MohamedReda2003/Robot-PROJET2A/Fichiers PDF/Initiation Projet 2A.pdf

Les grandes parties :

- Repérer les mauvaises herbes
https://www.agrireseau.net/documents/Document_114518.pdfhttps://docs.ultralytics.com/fr/tasks/segmenthttps://www.researchgate.net/publication/396391525_A_ROS_2-Based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 gn
- Faire bouger le bras (optimiser...)
- Faire déplacer le robot (chenille mécanique armature)
- Être capable de schématiser et visualiser le trajet et détecter tous les obstacles potentiels (on peut utiliser un Lidar360 pour cette tache)
- À rechercher si on peut ajouter le concept de PBC (Passivity-Based Control model) pour assurer l’équilibre du bras robotique lors de son fonctionnement
- Préparer les matrices de transformation du bras robotique pour la contrôler (MGD à DH modifiée et MGI)

https://docs.niryo.com/robots/ned2/electrical-interface/

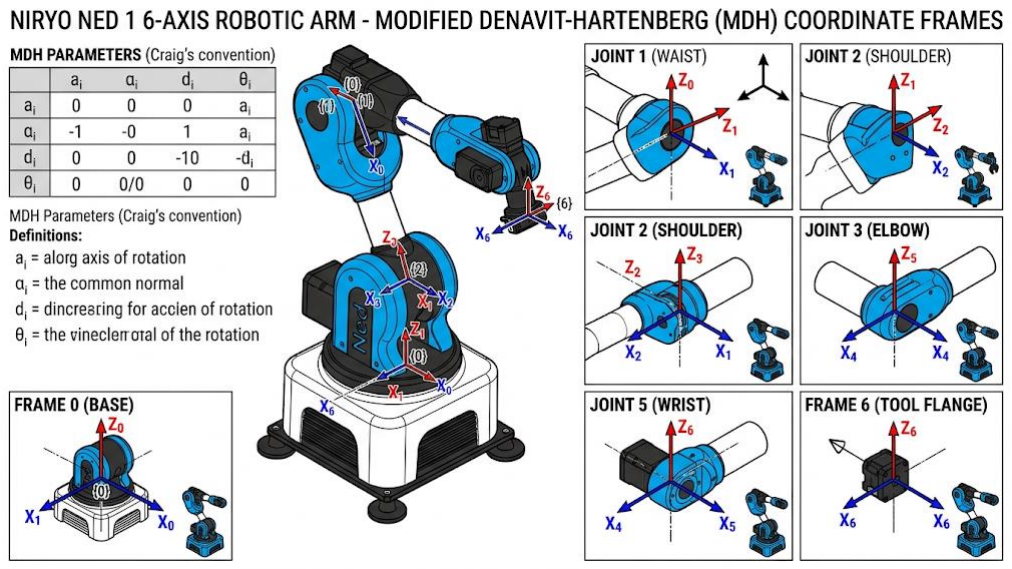
[picture p16: figure]

https://makerworld.com/fr/models/483628-tank-track-link-and-drivesprocket#profileId-395843
Des sites pour trouver des 3d gratuits :
- https://www.printables.com/
- https://grabcad.com/

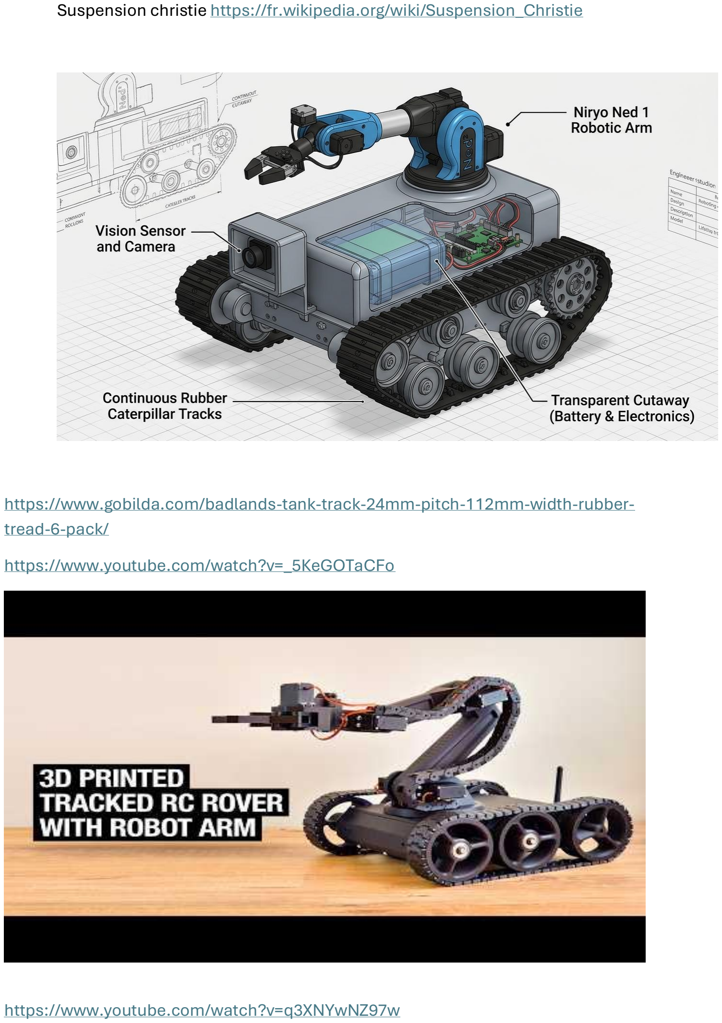
[picture p17: page 2]

Suspension christie https://fr.wikipedia.org/wiki/Suspension_Christie

https://www.gobilda.com/badlands-tank-track-24mm-pitch-112mm-width-rubbertread-6-pack/
https://www.youtube.com/watch?v=_5KeGOTaCFo

https://www.youtube.com/watch?v=q3XNYwNZ97w

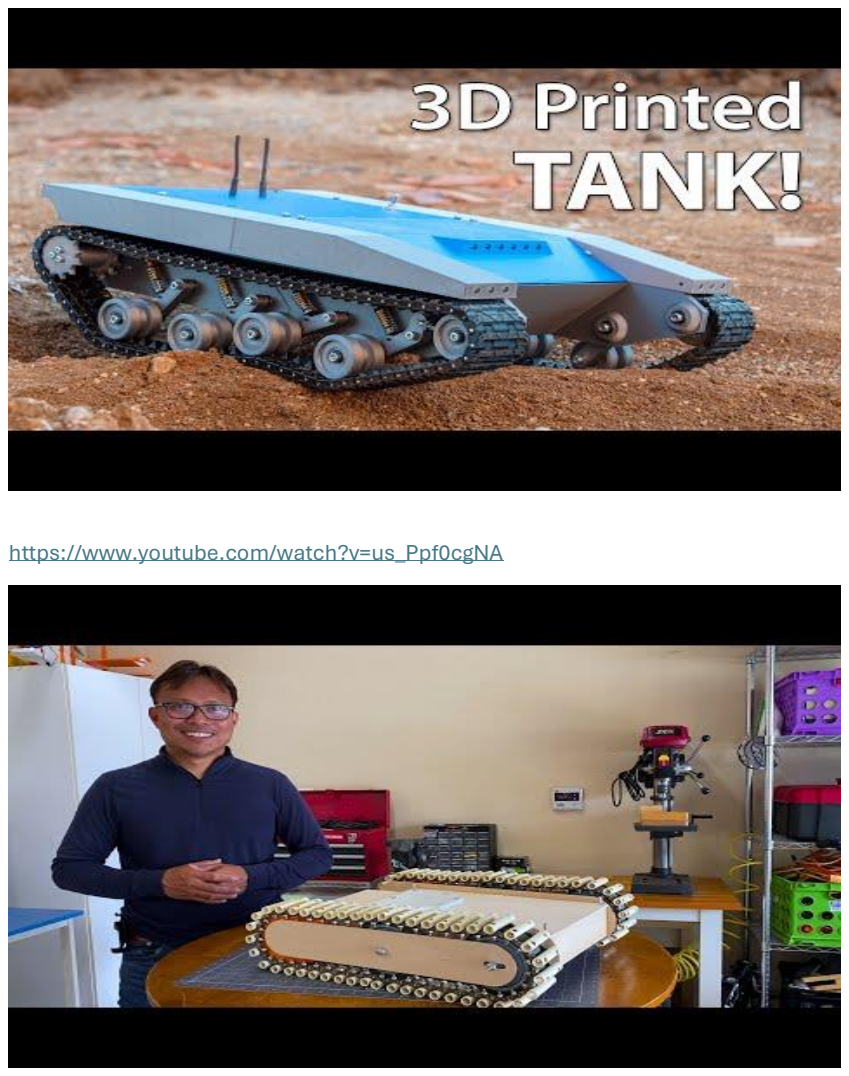
[picture p18: page 3]

https://www.youtube.com/watch?v=us_Ppf0cgNA
