MohamedReda2003/Robot-PROJET2A/ressources precedents/permabot-le-robot-chasseur-de-mauvaises-herbes.pdf

Permabot : le robot chasseur de mauvaises herbes https://dailyscience.be/28/04/2026/38464/

# PERMABOT : LE ROBOT CHASSEUR DE MAUVAISES HERBES

Publié le 28 avril 2026

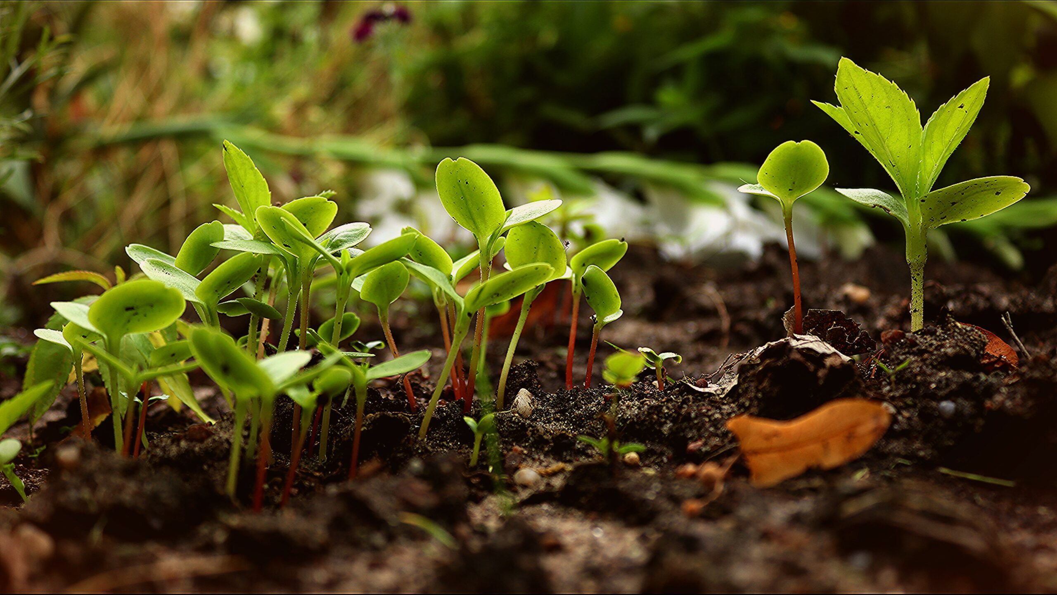
[picture p20: figure]

par Christian Du Brulle

PODCAST
Face aux défis croissants de lagriculture biologique et de la permaculture, Mohamed Hadjili, docteur en sciences appliquées, et Grégory Baltus, docteur en physique, développent à la Haute Ecole HE2B (https://he2b.be/) une solution innovante, « Permabot ». Leur ambition, et celle de leurs collègues impliqués dans ce projet à la Haute Ecole Louvain en Hainaut (HELHa) (https://www.helha.be/) et au Centre de recherche HELB, (https://www.helb-prigogine.be/la-recherche-2/) à Bruxelles, est claire : il sagit dalléger la pénibilité du désherbage manuel tout en respectant les principes écologiques.
Dans les systèmes agricoles sans pesticides, la gestion des adventices, appelées dans le langage populaire « mauvaises herbes », repose essentiellement sur le travail manuel. Une tâche exigeante, répétitive et chronophage. « Le désherbage est probablement le travail le plus contraignant en permaculture », explique Grégory Baltus. Réalisé à la main, il nécessite une vigilance quotidienne pour éviter que ces herbes indésirables népuisent les cultures.
Un bras robotisé et articulé
Cest précisément ce constat qui a donné naissance à Permabot. Le projet vise à concevoir un robot capable de reproduire mécaniquement les gestes du désherbage manuel grâce à un bras robotisé. Destiné aux petites exploitations et aux maraîchers bio, loutil se veut à la fois accessible et adapté à leurs besoins spécifiques.

Permabot : le robot chasseur de mauvaises herbes https://dailyscience.be/28/04/2026/38464/

Le dispositif repose sur plusieurs modules complémentaires. Au cur du système, un bras mécanique capable darracher les adventices avec précision. Mais cette prouesse technique ne serait rien sans une intelligence artificielle capable didentifier les plantes à éliminer. Grâce à lanalyse dimages, le robot distingue cultures et herbes indésirables, puis calcule la trajectoire optimale pour intervenir.
Loriginalité du projet réside également dans lintégration de technologies émergentes, comme l« imitation learning ». Cette approche permet au robot, qui aura à travailler dans un environnement agricole complexe et peu standardisé, dapprendre en observant les gestes humains. De quoi lui offrir une grande adaptabilité.
Un défi aussi économique
Contrairement aux robots agricoles existants, souvent conçus pour de grandes exploitations aux cultures alignées, Permabot cible les planches de permaculture, où les plantes poussent de manière dense et variée. Dans ce contexte, un simple robot roulant ne suffit pas. Doù lintérêt dun bras articulé monté sur un petit véhicule autonome capable de se déplacer avec précision.
« Les solutions actuelles coûtent environ 40.000 euros, un investissement difficilement accessible pour les petites structures », explique le Dr Hadjili. Les concepteurs de Permabot visent un prix inférieur à 20.000 euros, avec des modèles économiques alternatifs envisagés, comme la mutualisation entre agriculteurs ou la location de services.
Pour en appendre davantage sur ce projet, découvrez notre podcast (https://smartlink.ausha.co/les-podcasts-de-daily-science/permabot-le-robot-intelligent-pour-la-permacukture-avec-les-drs-mohamed-hadjili-et-gregory-baltus-de-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) enregistré avec les Drs Hadjili et Baltus lors de la dernière « Journée des Chercheurs » portée par le réseau SynHERA, (https://www.synhera.be/) de promotion de la recherche en Hautes Ecoles de la Fédération Wallonie-Bruxelles.
