MohamedReda2003/Robot-PROJET2A/ressources precedents/Sujet_TP_NED_2.pdf

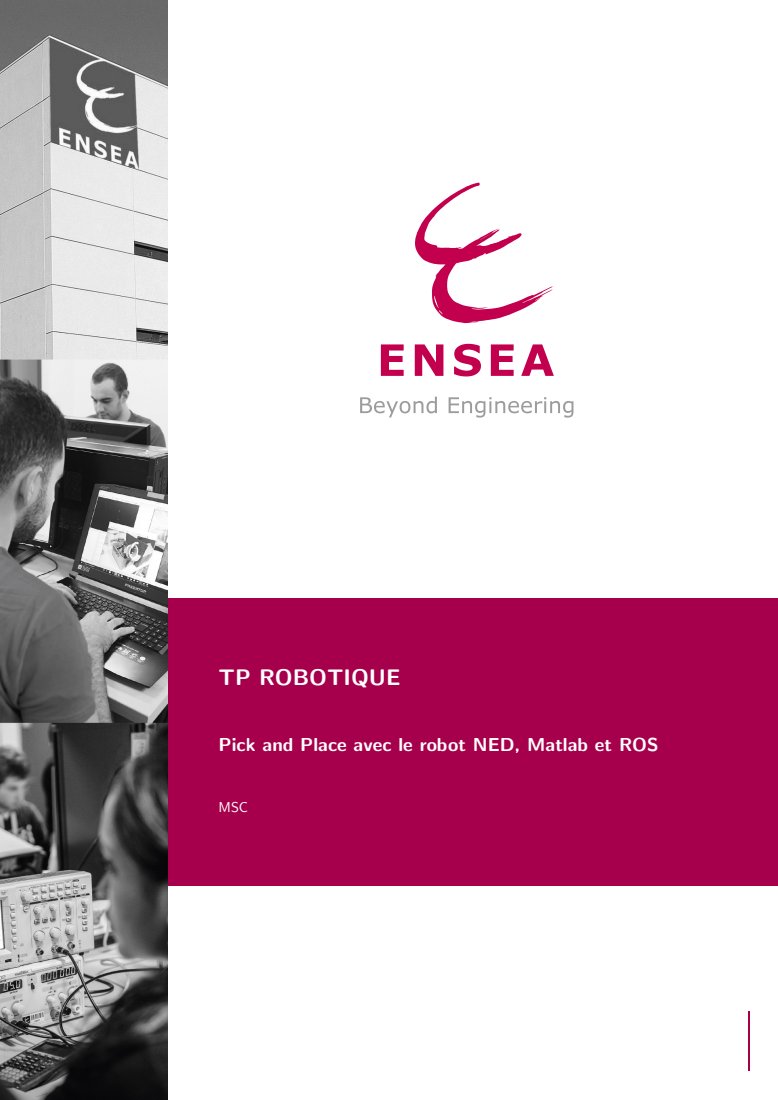
[picture p45: page 1]
TP ROBOTIQUE; MSC

Pick and Place avec le robot NED, Matlab et ROS

L’objectif de ce TP va être d’enregistrer une trajectoire avec différents points de passage afin de reproduire ensuite cette trajectoire.
Durant ce TP, pensez à créer différentes fonctions Matlab pour chaque partie afin d’avoir un code lisible. On pourra utiliser les fonctions Matlab f printf, input et disp pour interagir avec l’utilisateur.

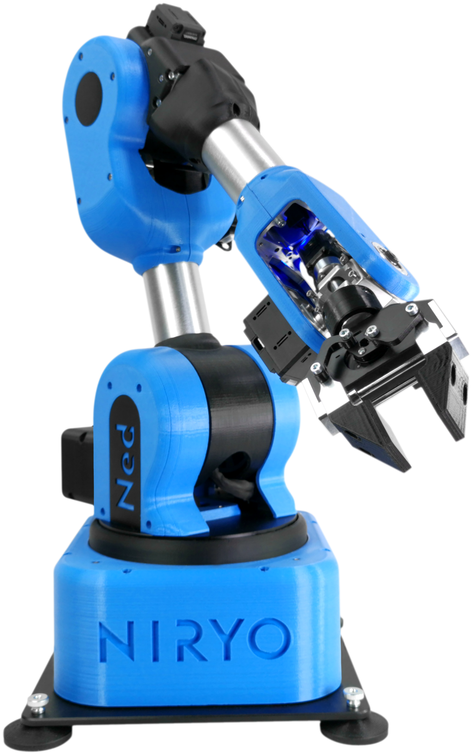
[picture p46: figure]

## Déplacement articulaire

Afin de déplacer le robot dans une position particulière, on utilisera le service
“niryo robot arm commander/manage trajectory”.
Créer une fonction Matlab Move Axis(Joints) avec pour argument un vecteur de positions articulaires et permettant d’atteindre cette position.

2

## Apprentissage d’une trajectoire

Créer une fonction Learn T rajectory(N points) avec pour argument un entier positif représentant le nombre de points de passage par lesquels passer et retournant les positions articulaires des points de passage à apprendre.
On pourra pour cela utiliser les fonction JointState() et LearningMode(ST AT E) créées lors du précédent TP.

## Reproduction d’une trajectoire

A partir de ces éléments, écrire une fonction Matlab T rajectory(P oints) ayant pour arguments un ensemble de positions articulaires par lesquels passer et permettant de reproduire une trajectoire.

## Commande de la pince

Trouver le service permettant de contrôler l’ouverture et la fermeture de la pince.
Créer une fonction Matlab Gripper(ST AT E) permettant d’ouvrir (ST AT E = 1) ou fermer (ST AT E = 0) la pince.

## Pick and Place

A partir des fonctions précédentes, créer une fonction Matlab P ick and Place() permettant d’apprendre puis reproduire une trajectoire afin de déplacer un objet d’un point A vers un point B. Le nombre de points de passage sera à rentrer par l’utilisateur.
Si besoin, on pourra utiliser la fonction Matlab pause(x).

## Optimisation

Afin d’optimiser le programme, recréer des fonctions en ajoutant en argument le(s) client(s) du(des) service(s) utilisé(s). Optimiser la fonction P ick and Place en appelant une seule fois par client la fonction Matlab rossvcclient (en début de programme).

3
