MohamedReda2003/Robot-PROJET2A/dh_modifie.png

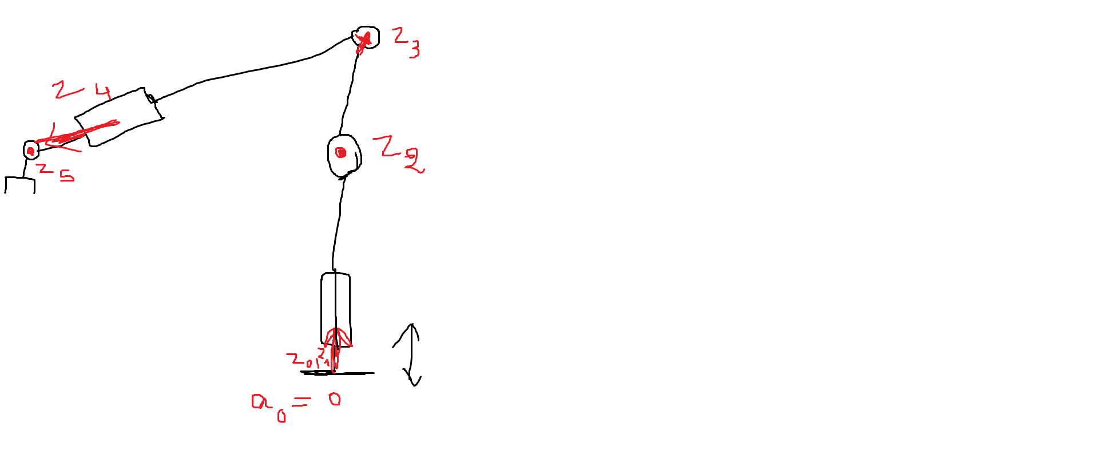
dh_modifie.png
