MohamedReda2003/Robot-PROJET2A/modele 3D mecanique du chassis/chenille unitaire/2400-0112-0001 6 Link Assembly.STEP

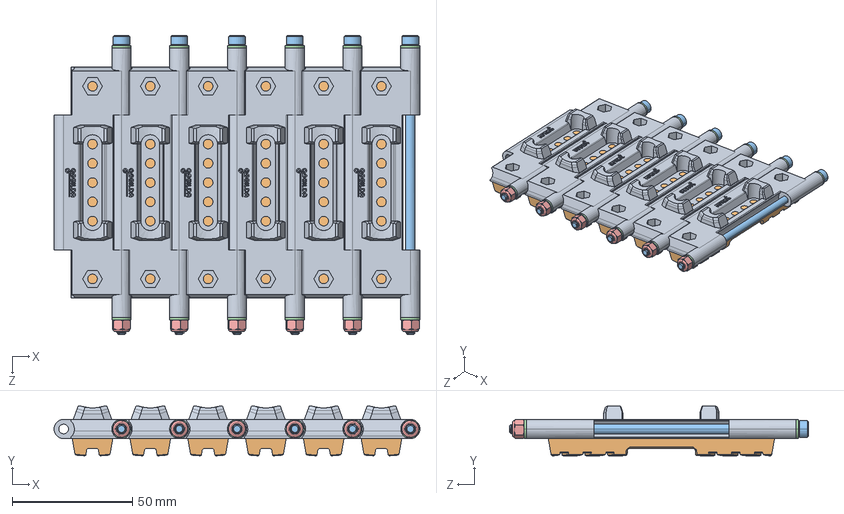
[picture p48: CAD file, 2026-11-03]
modele 3D mecanique du chassis/chenille unitaire/2400-0112-0001 6 Link Assembly.STEP
152.0 x 20.7 x 124.0 mm
2400-0112-0002 Link x 6
2400-0112-0001 Tread x 6
2400-0112-0002 Screw_90128A207 x 6
2801-0004-0008_91166A230 x 12
2812-0004-0007_90576A103 x 6
