MohamedReda2003/Robot-PROJET2A/modele 3D mecanique du chassis/STEP_chassis/Assemblage_chassis_UGV.step

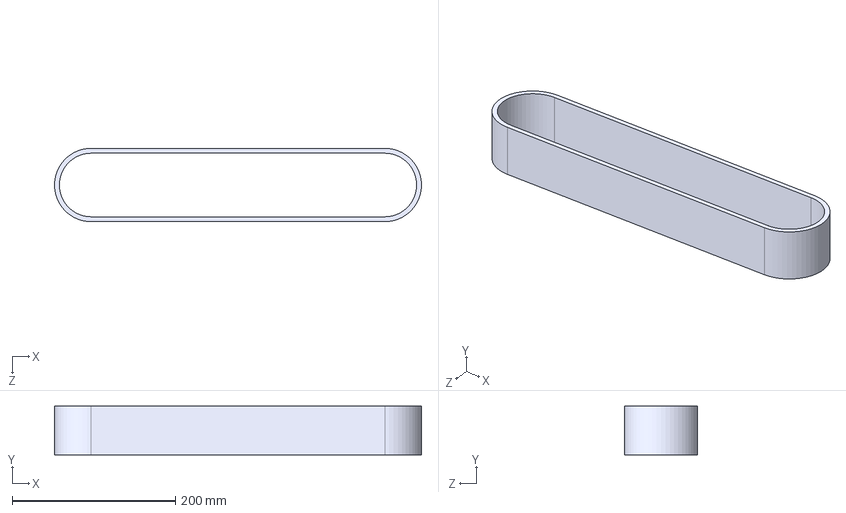
[picture p49: CAD file, 2026-11-03]
modele 3D mecanique du chassis/STEP_chassis/Assemblage_chassis_UGV.step
450.0 x 60.0 x 90.0 mm
