MohamedReda2003/Robot-PROJET2A/modele 3D mecanique du chassis/STEP_chassis/P09_roue_libre.step

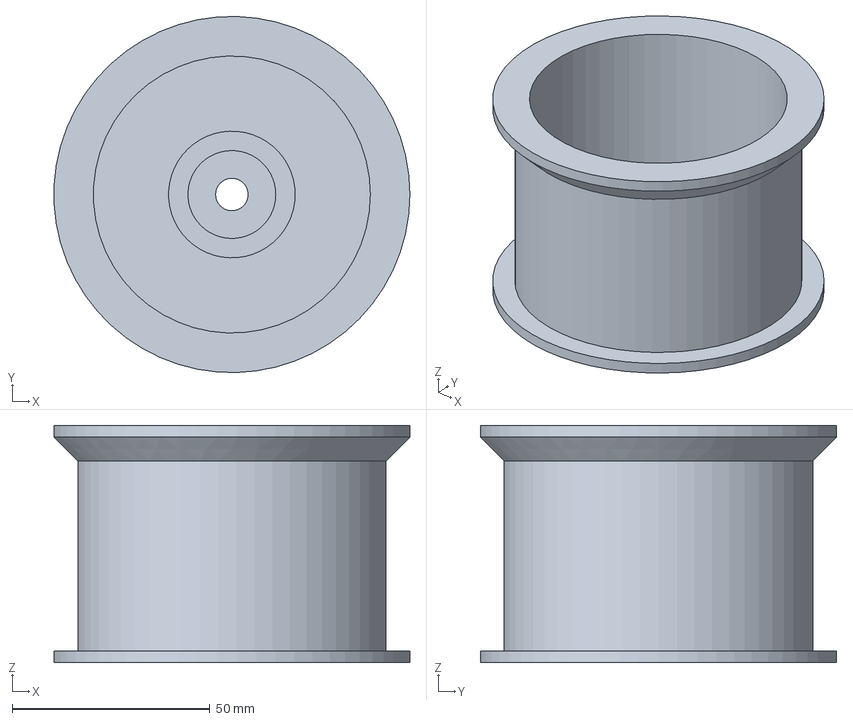
[picture p50: CAD file, 2026-11-02]
modele 3D mecanique du chassis/STEP_chassis/P09_roue_libre.step
89.9 x 90.0 x 60.0 mm
