MohamedReda2003/Robot-PROJET2A/modele 3D mecanique du chassis/STEP_chassis/P06_tuile_plancher.step

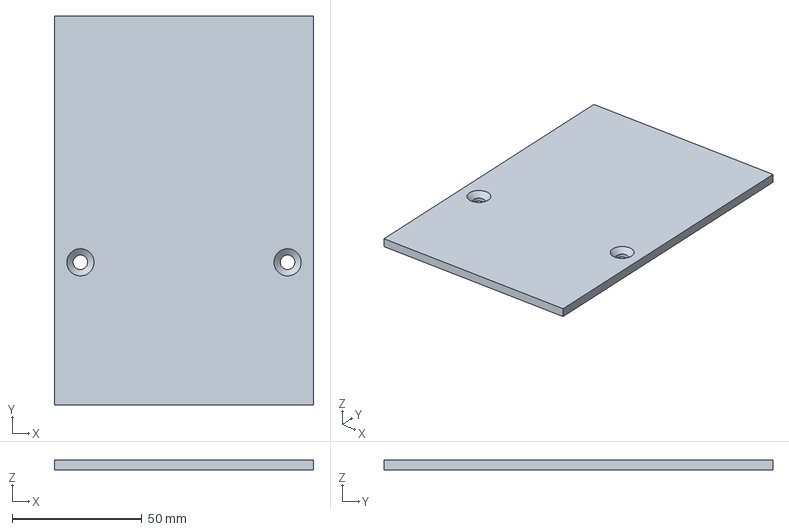
[picture p51: CAD file, 2026-11-02]
modele 3D mecanique du chassis/STEP_chassis/P06_tuile_plancher.step
100.0 x 150.0 x 4.00 mm
