MohamedReda2003/Robot-PROJET2A/modele 3D mecanique du chassis/STEP_chassis/P01A_longeron_arriere.step

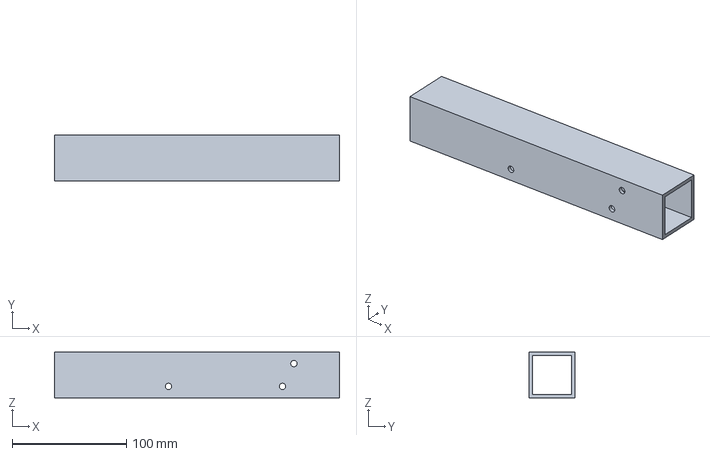
[picture p52: CAD file, 2026-11-02]
modele 3D mecanique du chassis/STEP_chassis/P01A_longeron_arriere.step
250.0 x 40.0 x 40.0 mm
