MohamedReda2003/Robot-PROJET2A/modele 3D mecanique du chassis/STEP_chassis/P07B_plaque_laterale_avant.step

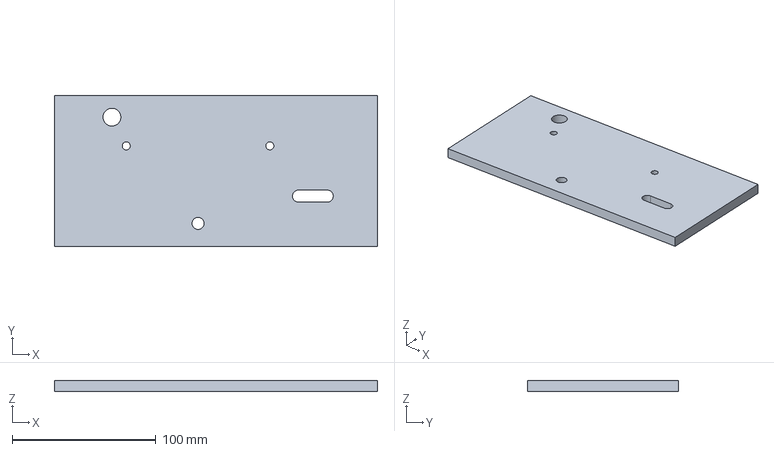
[picture p53: CAD file, 2026-11-02]
modele 3D mecanique du chassis/STEP_chassis/P07B_plaque_laterale_avant.step
225.0 x 105.0 x 8.00 mm
