MohamedReda2003/Robot-PROJET2A/modele 3D mecanique du chassis/STEP_chassis/P05_plaque_bras.step

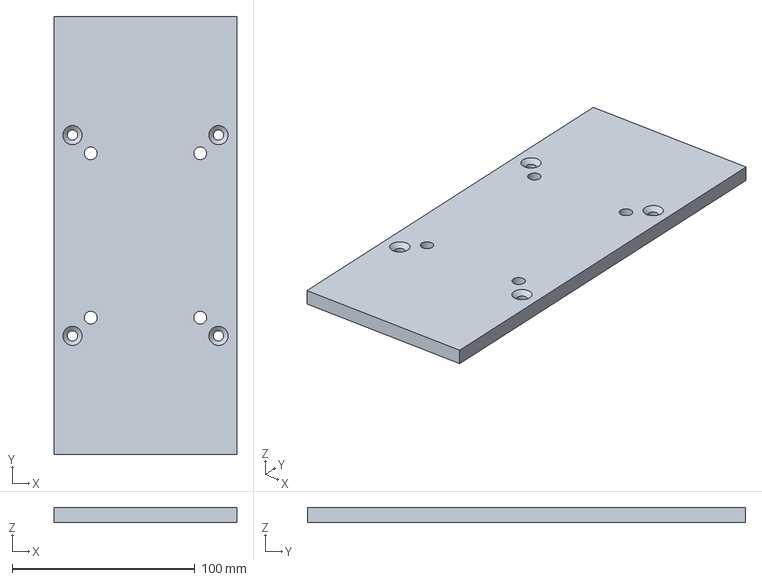
[picture p54: CAD file, 2026-11-02]
modele 3D mecanique du chassis/STEP_chassis/P05_plaque_bras.step
100.0 x 240.0 x 8.00 mm
