MohamedReda2003/Robot-PROJET2A/modele 3D mecanique du chassis/STEP_chassis/P08_roue_motrice.step

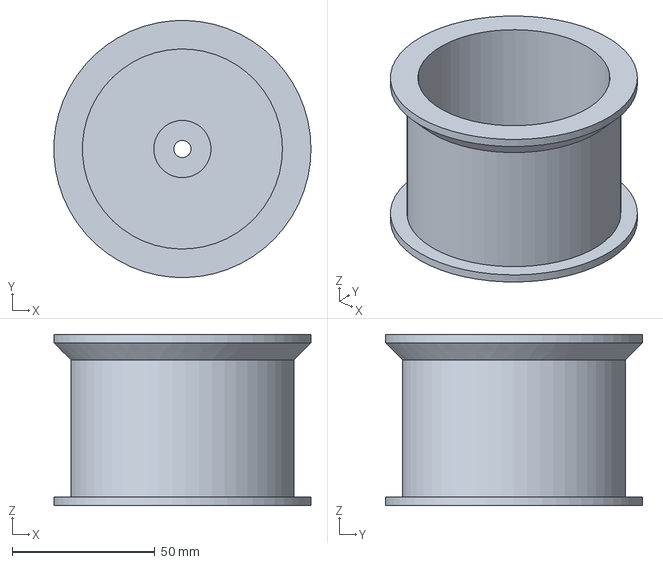
[picture p55: CAD file, 2026-11-02]
modele 3D mecanique du chassis/STEP_chassis/P08_roue_motrice.step
89.9 x 90.0 x 60.0 mm
