MohamedReda2003/Robot-PROJET2A/modele 3D mecanique du chassis/STEP_chassis/P03_traverse.step

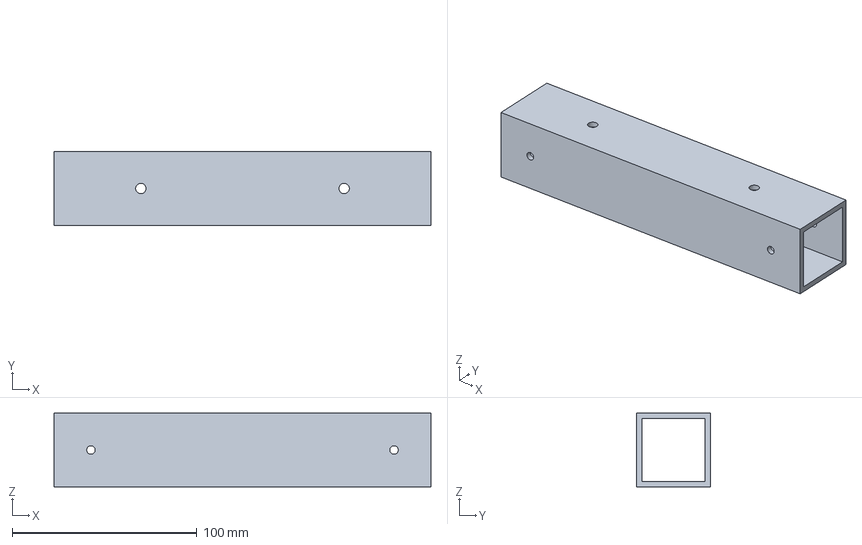
[picture p56: CAD file, 2026-11-02]
modele 3D mecanique du chassis/STEP_chassis/P03_traverse.step
204.0 x 40.0 x 40.0 mm
