MohamedReda2003/Robot-PROJET2A/modele 3D mecanique du chassis/STEP_chassis/P10_galet.step

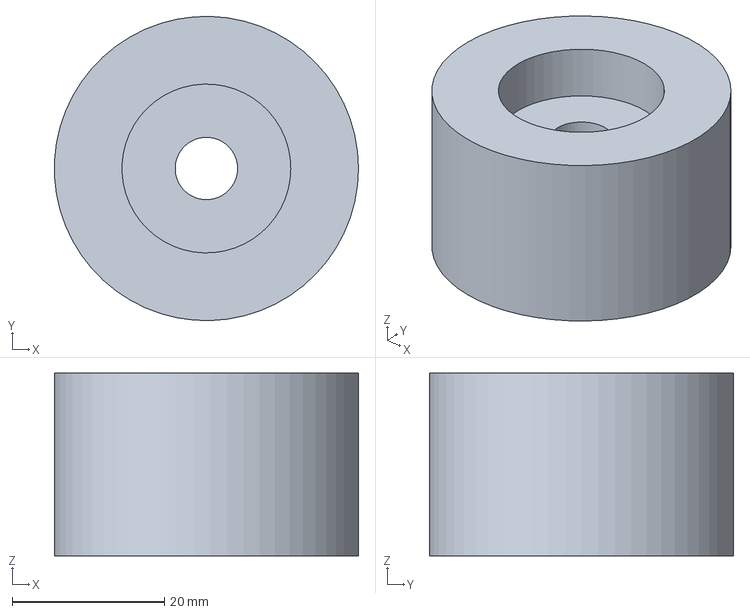
[picture p57: CAD file, 2026-11-02]
modele 3D mecanique du chassis/STEP_chassis/P10_galet.step
40.0 x 40.0 x 24.0 mm
