MohamedReda2003/Robot-PROJET2A/modele 3D mecanique du chassis/STEP_chassis/P02_manchon.step

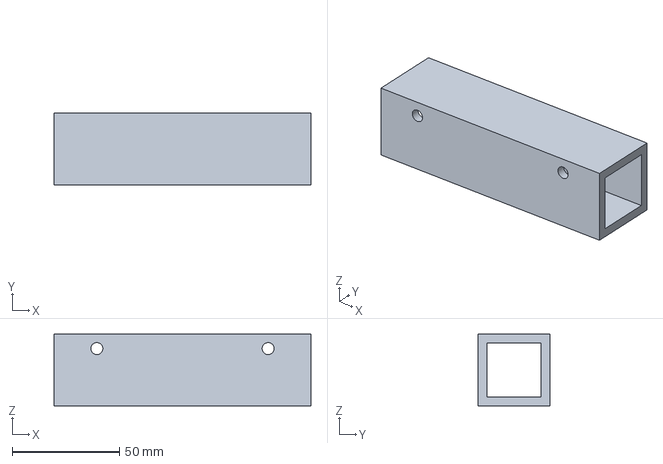
[picture p58: CAD file, 2026-11-02]
modele 3D mecanique du chassis/STEP_chassis/P02_manchon.step
120.0 x 33.4 x 33.4 mm
