MohamedReda2003/Robot-PROJET2A/modele 3D mecanique du chassis/STEP_chassis/P04_embase_traverse.step

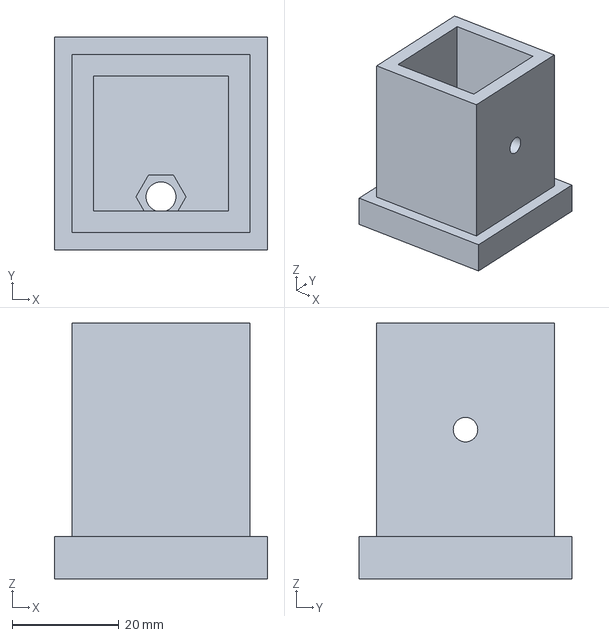
[picture p59: CAD file, 2026-11-02]
modele 3D mecanique du chassis/STEP_chassis/P04_embase_traverse.step
40.0 x 40.0 x 48.0 mm
