MohamedReda2003/Robot-PROJET2A/(list of files, cad)

Other CAD files:
modele 3D mecanique du chassis/STEP_chassis/P01B_longeron_avant.step
modele 3D mecanique du chassis/STEP_chassis/P07A_plaque_laterale_arriere.step
modele 3D mecanique du chassis/STEP_chassis/Assemblage_chassis_UGV.SLDASM
modele 3D mecanique du chassis/STL_chassis/P01A_longeron_arriere.stl
modele 3D mecanique du chassis/STL_chassis/P01B_longeron_avant.stl
modele 3D mecanique du chassis/STL_chassis/P02_manchon.stl
modele 3D mecanique du chassis/STL_chassis/P03_traverse.stl
modele 3D mecanique du chassis/STL_chassis/P04_embase_traverse.stl
modele 3D mecanique du chassis/STL_chassis/P05_plaque_bras.stl
modele 3D mecanique du chassis/STL_chassis/P06_tuile_plancher.stl
modele 3D mecanique du chassis/STL_chassis/P07A_plaque_laterale_arriere.stl
modele 3D mecanique du chassis/STL_chassis/P07B_plaque_laterale_avant.stl
modele 3D mecanique du chassis/STL_chassis/P08_roue_motrice.stl
modele 3D mecanique du chassis/STL_chassis/P09_roue_libre.stl
modele 3D mecanique du chassis/STL_chassis/P10_galet.stl
