MohamedReda2003/Robot-PROJET2A/(commit log)

2026-11-02 partie modele 3d chassis v0.1
    [Assemblage_chassis_UGV.step, P01A_longeron_arriere.step, P01B_longeron_avant.step, P02_manchon.step, P03_traverse.step, P04_embase_traverse.step, P05_plaque_bras.step, P06_tuile_plancher.step]
2026-11-02 mise à jour de la partie conception mécanique
    [Assemblage_chassis_UGV.step, P01A_longeron_arriere.step, P01A_longeron_arriere.stl, P01B_longeron_avant.step, P01B_longeron_avant.stl, P02_manchon.step, P02_manchon.stl, P03_traverse.step]
2026-11-03 03/11/2026 :15:21
    [2400-0112-0001 6 Link Assembly.STEP, Assemblage_chassis_UGV.SLDASM]
2026-11-03 03/11/2026 :17:24
    [Assemblage_chassis_UGV.SLDASM, Assemblage_chassis_UGV.step]
